ISU-MAVRIC/MAVRIC_Main/README.md

MAVRIC Main Controller
===========

Hardware and firmware for MAVRIC's main control system

Hardware design files use the [Aerodyne Labs KiCad library](https://github.com/aerodynelabs/kicadlib)

Based off the [ChipKit MAX32](http://www.digilentinc.com/Products/Detail.cfm?NavPath=2,892,894&Prod=CHIPKIT-MAX32)
