ISU-MAVRIC/MAVRIC_Main/(threads)

Thread 10 (2015-02-18):

Add microcontroller power components to board inc. regulator

markrusciano, 2015-02-18:
Using the Arm Board schematic as reference, add a 3.3V regulator to the board and connect them to the microcontroller. Use the AOZ1280 regulator. The STM32F401 datasheet is in the MAVRIC_Arm repository for power reference. Page 57 has a nice overview.

djmallek, 2015-02-21:
Layed out the STM pins, created the 3.3v regulator, hooked up 3.3v to microcontroller, and hooked up an oscillator.

Closed 2015-03-07.

Thread 11 (2015-02-18):

Add RS485 transceiver to board

markrusciano, 2015-02-18:
Use the same part that the arm board uses. The datasheet is in the MAVRIC_Arm repo as _sn65176b Datasheet.pdf_. You will need to add a terminating resistance across lines _A_ and _B_. It will be 100 Ohms. See the arm board for reference, it will be nearly identical. Use the same connector as the arm board.

A 5V regulator will also be necessary for the transceiver. Use the AOZ1280. A 5V configuration is available for reference on the arm board. I'd recommend putting the two regulators (3.3 and 5V) on a hierarchical sheet. http://en.wikibooks.org/wiki/Kicad/eeschema/Hierarchical_Sheets

Closed 2015-03-07.

Thread 9 (2015-02-18):

Layout F401 on board

markrusciano, 2015-02-18:
Using the MAVRIClib in ISU_MAVRIC/MAVRIC_Hardware, place all parts of the F401 on the board. Use the Arm Board as reference

djmallek, 2015-02-21:
I layed out all the parts for the F401.

Closed 2015-02-21.

Thread 12 (2015-03-09):

Add RJ45 connectors to schematic

markrusciano, 2015-03-09:
- [x] Wheel Pods 1-6
- [x] Arm control board

markrusciano, 2015-04-07:
Updated requirements:
- [ ] One jack for wheel pods left (we are splicing the three together)
- [ ] One jack for wheel pods right (splicing the three wheel pods together)
- [ ] One jack for Arm Control Board
- [ ] One spare jack

djmallek, 2015-05-02:
Changed spare RS485 to RS232

Closed 2015-05-02.

Thread 14 (2015-04-02):

Add Vernier Sensors to Board

markrusciano, 2015-04-02:
Sparkfun Board: http://www.vernier.com/products/interfaces/bt-ard/
- [x] pH sensor
   - [x] Figure out how to scale voltage (goes through a Vernier BNC amplifier)
   - [x] Create schematic part and board footprint for the analog British telecom plug
   - [x] Add to board, assign analog port in _cube_
- [x] Soil Moisture Sensor
 - [x] Figure out how to scale voltage (goes through a Vernier BNC amplifier)
 - [x] Add to board, assign analog port in _cube_

markrusciano, 2015-04-02:
Notes on 5V to 3.3V on Page 38 here
http://www.newark.com/pdfs/techarticles/microchip/3_3vto5vAnalogTipsnTricksBrchr.pdf

markrusciano, 2015-04-02:
Ordered bta jacks for testing on breadboard
https://www.sparkfun.com/products/12753

djmallek, 2015-05-02:
Hardware is done.

Closed 2015-06-22.

Thread 15 (2015-04-02):

Add 5V and 3V3 Regulators to Main Board

markrusciano, 2015-04-02:
- [x] 5V [AOZ1280CI](http://www.digikey.com/product-detail/en/AOZ1280CI/785-1277-1-ND/2769845)
  - [x] Added to schematic (wired to ethernet jacks)

- [x] 3V3 [AOZ1280CI](http://www.digikey.com/product-detail/en/AOZ1280CI/785-1277-1-ND/2769845)
  - [x] Added to schematic (wired to ethernet jacks)

Closed 2015-04-04.

Thread 16 (2015-04-07):

Spare Connectors

markrusciano, 2015-04-07:
The main board is probably the most volatile part of the MAVRIC electronics right now. Due to that lets add
- [x] 5 Spare GPIO I/O pins on a header
- [x] 3 Spare ADC pins on a header

Closed 2015-05-02.

Thread 17 (2015-04-07):

RFD900 Power Regulator Replacement.

markrusciano, 2015-04-07:
The RFD900 radio will be interfacing directly with the main board. It draws 800mA at 5V which may overdraw our current regulator. We might as well upgrade to one of the AP***** regulators we have used on the main board.

-[ ] Replace AOZ regulator with AP regulator (5A) running at 5V
-[ ] Add header for connecting to RFD according to pinout here http://rfdesign.com.au/index.php/rfd900 (we will only need 5V, GND, RX and TX. ) Don't connect RX and TX to anything quite yet, we still need to figure out where we want those to go.
