ISU-MAVRIC/MAVRIC_Main/Hardware/Main Board.kicad_pcb

## KiCad design Hardware/Main Board.kicad_pcb (2015-05-05)

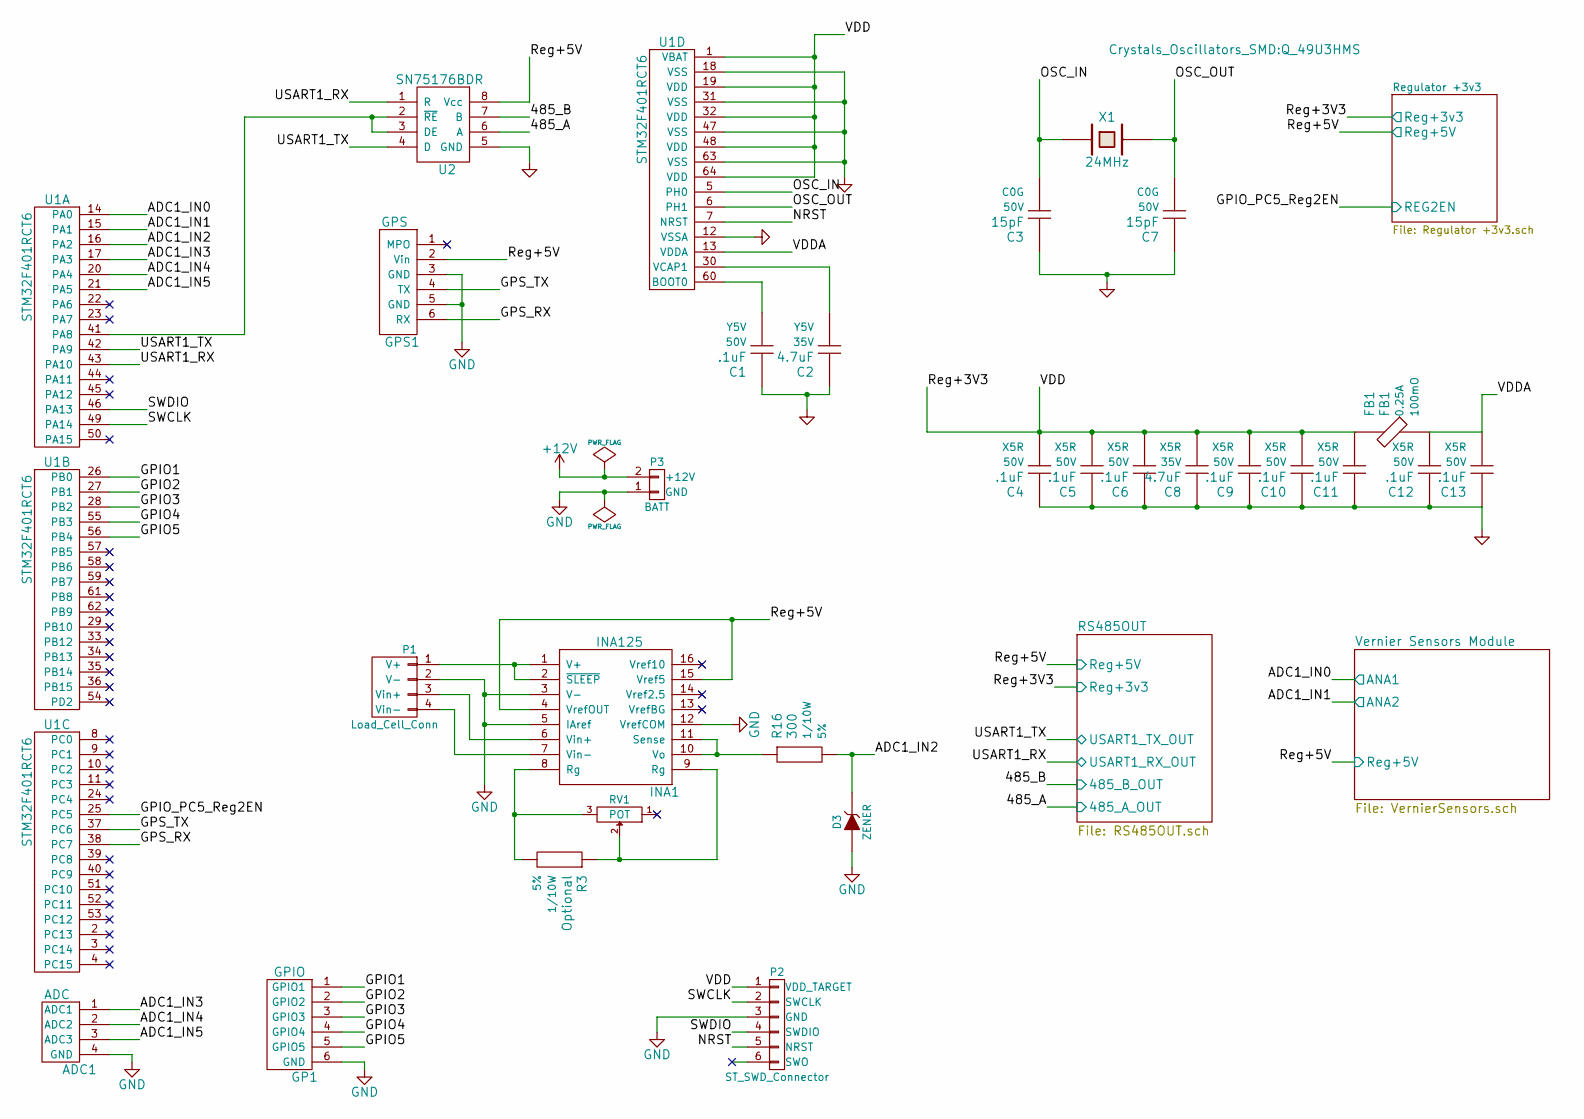
[picture p1: schematic Main Board.sch]

Parts:
ADC1: ADC; 1x4_SMD_header
C1, C4, C5, C6, C9, C10, C11, C12, C13: .1uF; C_1206_HandSoldering; Voltage 50V; Manufacturer Part # Value
C2, C8: 4.7uF; C_1206_HandSoldering; Voltage 35V; Manufacturer Part # Value
C3, C7: 15pF; C_1206_HandSoldering; Voltage 50V; Manufacturer Part # Value
D3: ZENER; Diode-SMA_Handsoldering
FB1: FB1; R_1206_HandSoldering; Manufacturer Part # Value
GP1: GPIO; 1x6_SMD_header
GPS1: GPS; GPS_Pads
INA1: INA125; SOIC-16_3.9x9.9mm_Pitch1.27mm
P1: Load_Cell_Conn; 1x4_SMD_header
P2: ST_SWD_Connector; 1x6_Breakaway_Header
P3: BATT; SolderWirePad_2x_2-5mmDrill
R3: Optional; R_1206_HandSoldering; Tolerance 5%; Manufacturer Part # Value
R16: 300; R_1206_HandSoldering; Tolerance 5%; Manufacturer Part # Value
RV1: POT; Potentiometer_Bourns_3006P_Angular_ScrewFront
U1: STM32F401RCT6; LQFP-64_10x10mm_Pitch0.5mm
U2: SN75176BDR; SOIC-8_3.9x4.9mm_Pitch1.27mm
X1: 24MHz; Q_49U3HMS

Connections:
+12V: P3.2 (+12V); also elsewhere on the board
/ADC1_IN2: D3.2 (K), R16.2, U1.16 (PA2)
/ADC1_IN3: ADC1.1 (ADC1), U1.17 (PA3)
/ADC1_IN4: ADC1.2 (ADC2), U1.20 (PA4)
/ADC1_IN5: ADC1.3 (ADC3), U1.21 (PA5)
/GPIO1: GP1.1 (GPIO1), U1.26 (PB0)
/GPIO2: GP1.2 (GPIO2), U1.27 (PB1)
/GPIO3: GP1.3 (GPIO3), U1.28 (PB2)
/GPIO4: GP1.4 (GPIO4), U1.55 (PB3)
/GPIO5: GP1.5 (GPIO5), U1.56 (PB4)
/GPS_RX: GPS1.6 (RX), U1.38 (PC7)
/GPS_TX: GPS1.4 (TX), U1.37 (PC6)
/NRST: P2.5 (NRST), U1.7 (NRST)
/OSC_IN: C3.2, U1.5 (PH0), X1.1
/OSC_OUT: C7.2, U1.6 (PH1), X1.2
/RS485OUT/485_A_OUT: U2.6 (A); also elsewhere on the board
/RS485OUT/485_B_OUT: U2.7 (B); also elsewhere on the board
/RS485OUT/Reg+3V3: C4.2, C5.2, C6.2, C8.2, C9.2, C10.2, C11.2, FB1.1, P2.1 (VDD_TARGET), U1.1 (VBAT), U1.19 (VDD), U1.32 (VDD), U1.48 (VDD), U1.64 (VDD); also elsewhere on the board
/RS485OUT/Reg+5V: GPS1.2 (Vin), INA1.4 (VrefOUT), INA1.15 (Vref5), U2.8 (Vcc); also elsewhere on the board
/RS485OUT/USART1_RX_OUT: U1.43 (PA10), U2.1 (R); also elsewhere on the board
/RS485OUT/USART1_TX_OUT: U1.42 (PA9), U2.4 (D); also elsewhere on the board
/Regulator +3v3/REG2EN: U1.25 (PC5); also elsewhere on the board
/SWCLK: P2.2 (SWCLK), U1.49 (PA14)
/SWDIO: P2.4 (SWDIO), U1.46 (PA13)
/VDDA: C12.2, C13.2, FB1.2, U1.13 (VDDA)
/Vernier Sensors Module/ANA1: U1.14 (PA0); also elsewhere on the board
/Vernier Sensors Module/ANA2: U1.15 (PA1); also elsewhere on the board
GND: ADC1.4 (GND), C1.1, C2.1, C3.1, C4.1, C5.1, C6.1, C7.1, C8.1, C9.1, C10.1, C11.1, C12.1, C13.1, D3.1 (A), GP1.6 (GND), GPS1.3 (GND), GPS1.5 (GND), INA1.3 (V-), INA1.5 (IAref), INA1.12 (VrefCOM), P1.2 (V-), P2.3 (GND), P3.1 (GND), U1.12 (VSSA), U1.18 (VSS), U1.31 (VSS), U1.47 (VSS), U1.63 (VSS), U2.5 (GND); also elsewhere on the board
unnamed: C1.2, U1.60 (BOOT0)
unnamed: C2.2, U1.30 (VCAP1)
unnamed: INA1.1 (V+), INA1.2 (~SLEEP), P1.1 (V+)
unnamed: INA1.6 (Vin+), P1.3 (Vin+)
unnamed: INA1.7 (Vin-), P1.4 (Vin-)
unnamed: INA1.8 (Rg), R3.2, RV1.3
unnamed: INA1.9 (Rg), R3.1, RV1.2
unnamed: INA1.10 (Vo), INA1.11 (Sense), R16.1
unnamed: U1.41 (PA8), U2.2 (~RE), U2.3 (DE)

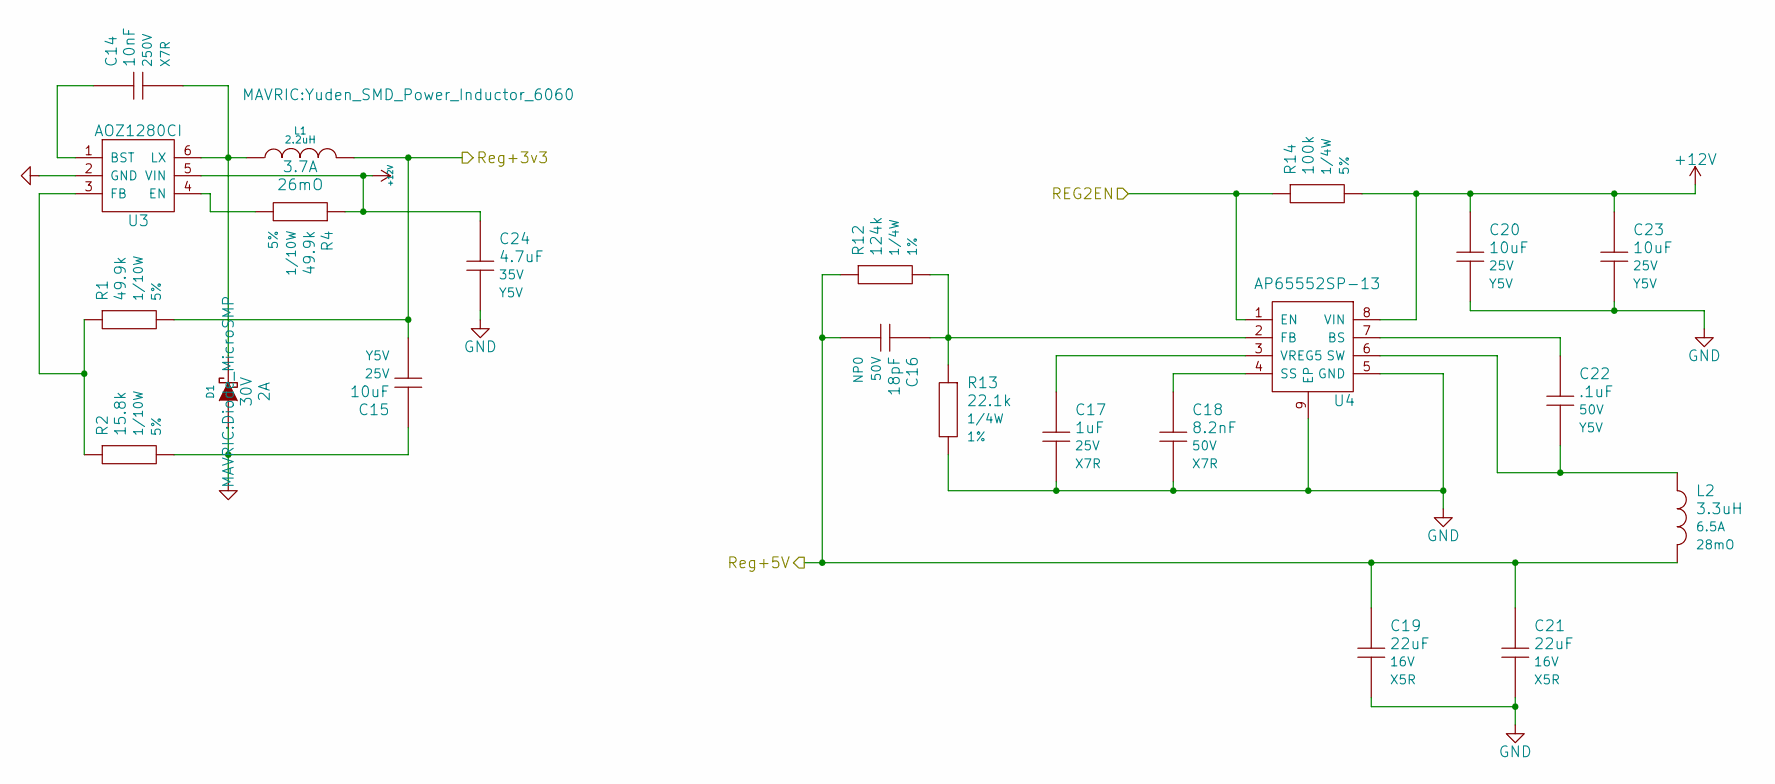
[picture p2: schematic Regulator +3v3.sch]

Parts:
C14: 10nF; C_1206_HandSoldering; Voltage 250V; Manufacturer Part # Value
C15, C20, C23: 10uF; C_1206_HandSoldering; Voltage 25V; Manufacturer Part # Value
C16: 18pF; C_1206_HandSoldering; Voltage 50V; Manufacturer Part # Value
C17: 1uF; C_1206_HandSoldering; Voltage 25V; Manufacturer Part # Value
C18: 8.2nF; C_1206_HandSoldering; Voltage 50V; Manufacturer Part # Value
C19, C21: 22uF; C_1206_HandSoldering; Voltage 16V; Manufacturer Part # Value
C22: .1uF; C_1206_HandSoldering; Voltage 50V; Manufacturer Part # Value
C24: 4.7uF; C_1206_HandSoldering; Voltage 35V; Manufacturer Part # Value
D1: DIODESCH; Diode_MicroSMP; Reverse Voltage 30V
L1: 2.2uH; Yuden_SMD_Power_Inductor_6060
L2: 3.3uH; Neosid_Inductor_SM-PIC0612H; Manufacturer Part # Value
R1, R4: 49.9k; R_1206_HandSoldering; Tolerance 5%; Manufacturer Part # Value
R2: 15.8k; R_1206_HandSoldering; Tolerance 5%; Manufacturer Part # Value
R12: 124k; R_1206_HandSoldering; Tolerance 1%; Manufacturer Part # Value
R13: 22.1k; R_1206_HandSoldering; Tolerance 1%; Manufacturer Part # Value
R14: 100k; R_1206_HandSoldering; Tolerance 5%; Manufacturer Part # Value
U3: AOZ1280CI; SOT-23-6
U4: AP65552SP-13; SOIC-8-1EP_3.9x4.9mm_Pitch1.27mm

Connections:
+12V: C20.1, C23.1, C24.1, R4.1, R14.2, U3.5 (VIN), U4.8 (VIN); also elsewhere on the board
/RS485OUT/Reg+3V3: C15.2, L1.2, R1.2; also elsewhere on the board
/RS485OUT/Reg+5V: C16.2, C19.1, C21.1, L2.2, R12.1; also elsewhere on the board
/Regulator +3v3/REG2EN: R14.1, U4.1 (EN); also elsewhere on the board
GND: C15.1, C17.2, C18.2, C19.2, C20.2, C21.2, C23.2, C24.2, D1.1 (A), R2.2, R13.2, U3.2 (GND), U4.5 (GND), U4.9 (EP); also elsewhere on the board
unnamed: C14.1, U3.1 (BST)
unnamed: C14.2, D1.2 (K), L1.1, U3.6 (LX)
unnamed: C16.1, R12.2, R13.1, U4.2 (FB)
unnamed: C17.1, U4.3 (VREG5)
unnamed: C18.1, U4.4 (SS)
unnamed: C22.1, U4.7 (BS)
unnamed: C22.2, L2.1, U4.6 (SW)
unnamed: R1.1, R2.1, U3.3 (FB)
unnamed: R4.2, U3.4 (EN)

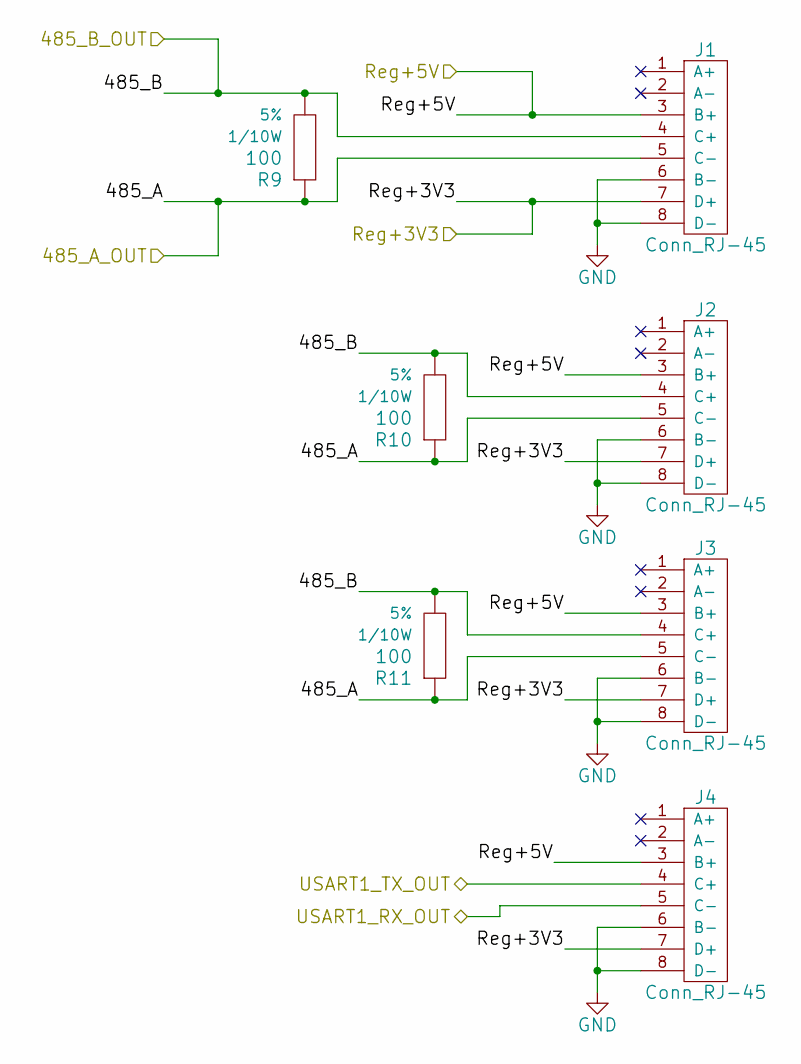
[picture p3: schematic RS485OUT.sch]

Parts:
J1, J2, J3, J4: Conn_RJ-45; Molex_RJ45_0437438101
R9, R10, R11: 100; R_1206_HandSoldering; Tolerance 5%; Manufacturer Part # Value

Connections:
/RS485OUT/485_A_OUT: J1.5 (C-), J2.5 (C-), J3.5 (C-), R9.1, R10.1, R11.1; also elsewhere on the board
/RS485OUT/485_B_OUT: J1.4 (C+), J2.4 (C+), J3.4 (C+), R9.2, R10.2, R11.2; also elsewhere on the board
/RS485OUT/Reg+3V3: J1.7 (D+), J2.7 (D+), J3.7 (D+), J4.7 (D+); also elsewhere on the board
/RS485OUT/Reg+5V: J1.3 (B+), J2.3 (B+), J3.3 (B+), J4.3 (B+); also elsewhere on the board
/RS485OUT/USART1_RX_OUT: J4.5 (C-); also elsewhere on the board
/RS485OUT/USART1_TX_OUT: J4.4 (C+); also elsewhere on the board
GND: J1.6 (B-), J1.8 (D-), J2.6 (B-), J2.8 (D-), J3.6 (B-), J3.8 (D-), J4.6 (B-), J4.8 (D-); also elsewhere on the board

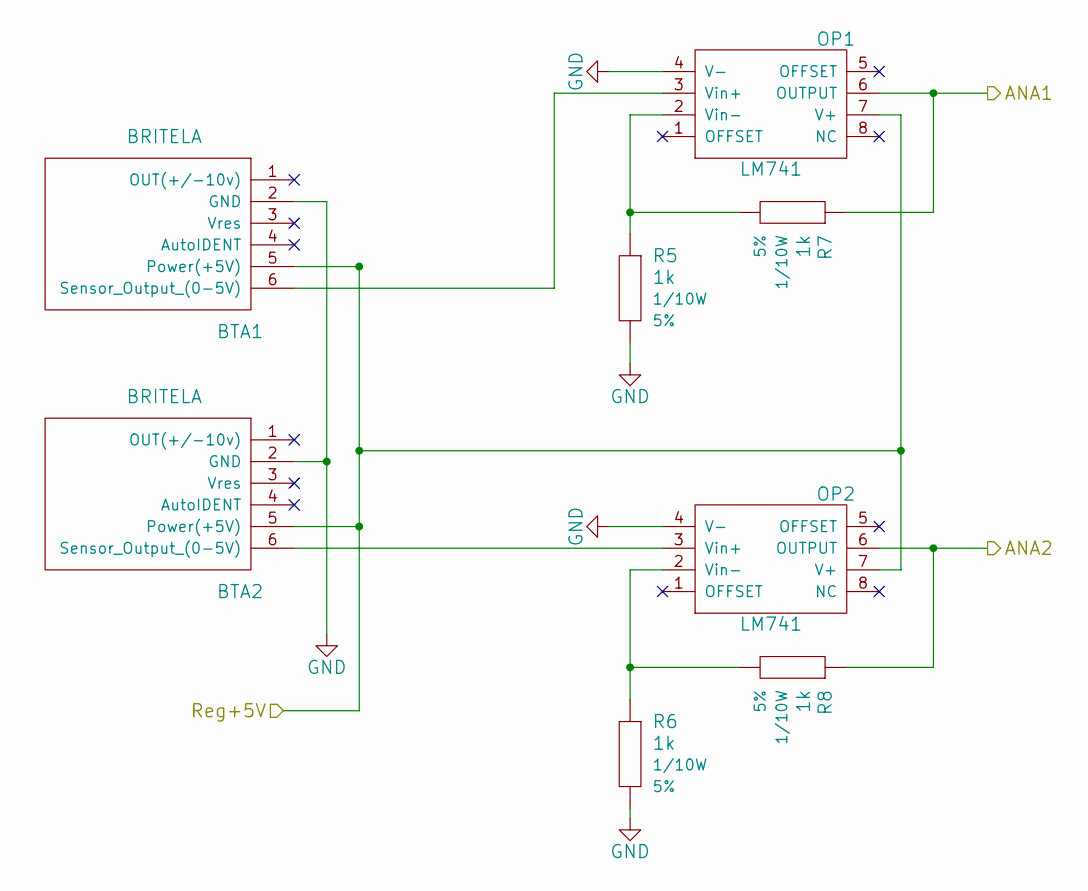
[picture p4: schematic VernierSensors.sch]

Parts:
BTA1, BTA2: BRITELA; BTA
OP1, OP2: LM741; SOIC-8_3.9x4.9mm_Pitch1.27mm
R5, R6, R7, R8: 1k; R_1206_HandSoldering; Tolerance 5%; Manufacturer Part # Value

Connections:
/RS485OUT/Reg+5V: BTA1.5 (Power(+5V)), BTA2.5 (Power(+5V)), OP1.7 (V+), OP2.7 (V+); also elsewhere on the board
/Vernier Sensors Module/ANA1: OP1.6 (OUTPUT), R7.1; also elsewhere on the board
/Vernier Sensors Module/ANA2: OP2.6 (OUTPUT), R8.1; also elsewhere on the board
GND: BTA1.2 (GND), BTA2.2 (GND), OP1.4 (V-), OP2.4 (V-), R5.2, R6.2; also elsewhere on the board
unnamed: BTA1.6 (Sensor_Output_(0-5V)), OP1.3 (Vin+)
unnamed: BTA2.6 (Sensor_Output_(0-5V)), OP2.3 (Vin+)
unnamed: OP1.2 (Vin-), R5.1, R7.2
unnamed: OP2.2 (Vin-), R6.1, R8.2

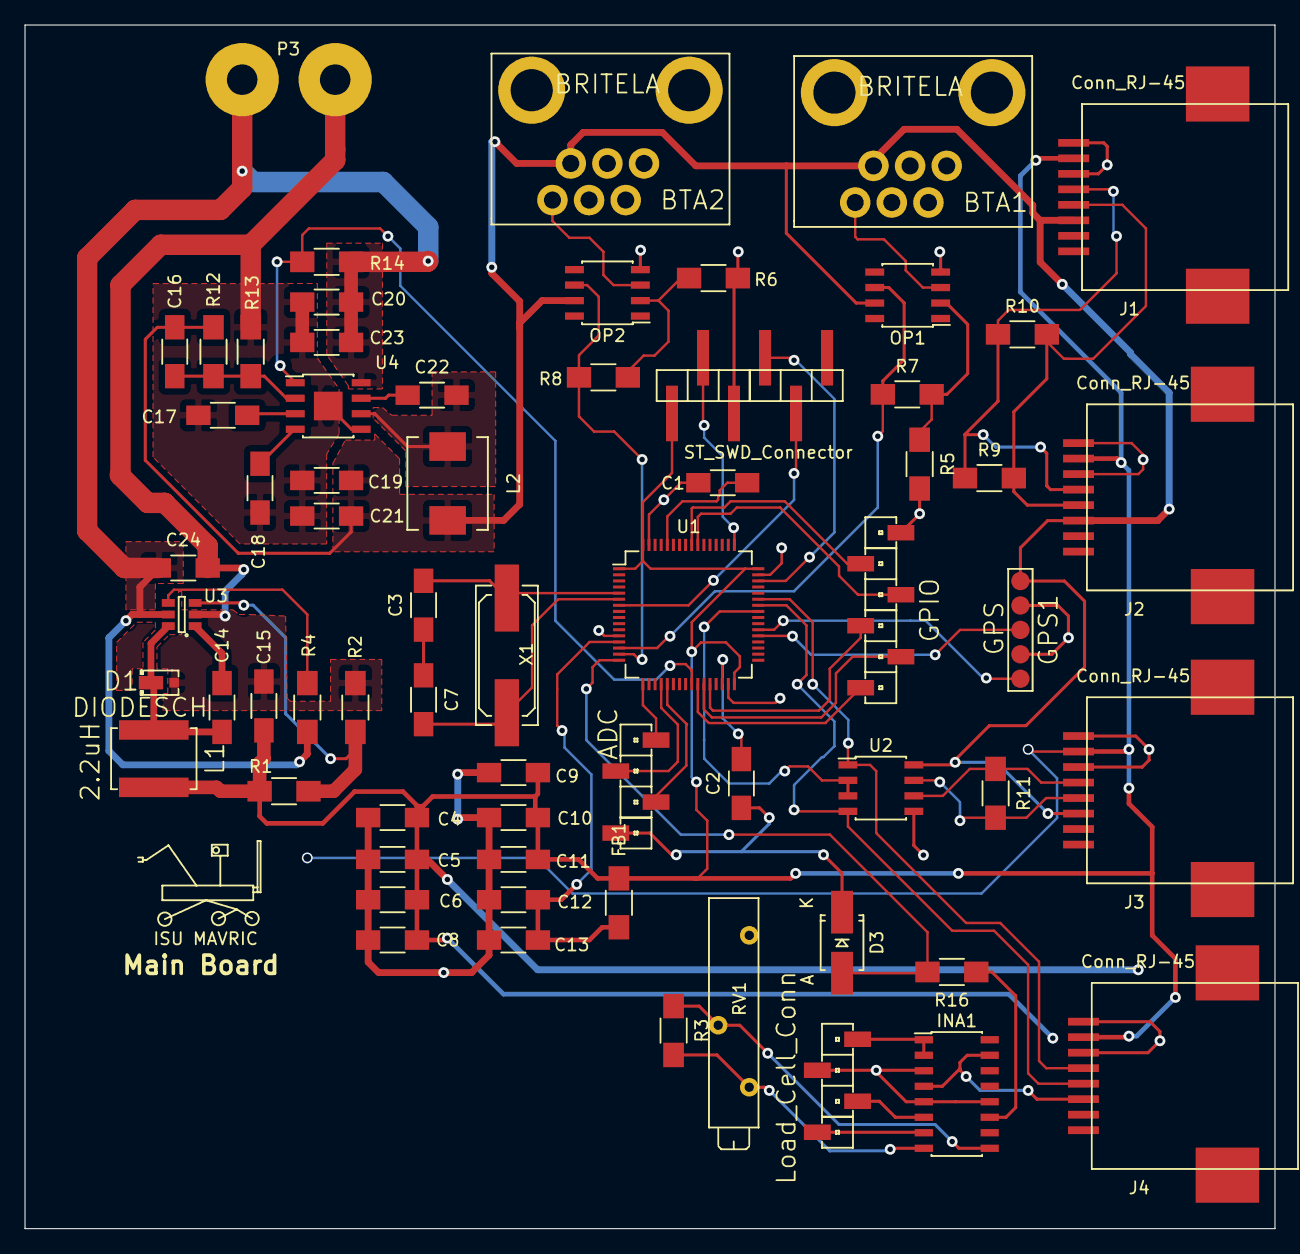
[picture p5: board Main Board.kicad_pcb from above]

Board: 2 copper layers, 102.4 x 98.6 mm, 66 parts (0 on the bottom side), 50 nets.

Other parts of the board:
ISU MAVRIC: VAL**; MAVRIC_LOGO
