ISU-MAVRIC/MAVRIC_Main/Hardware/MAVRIC-Main.kicad_pcb

## KiCad design Hardware/MAVRIC-Main.kicad_pcb (2013-09-12)

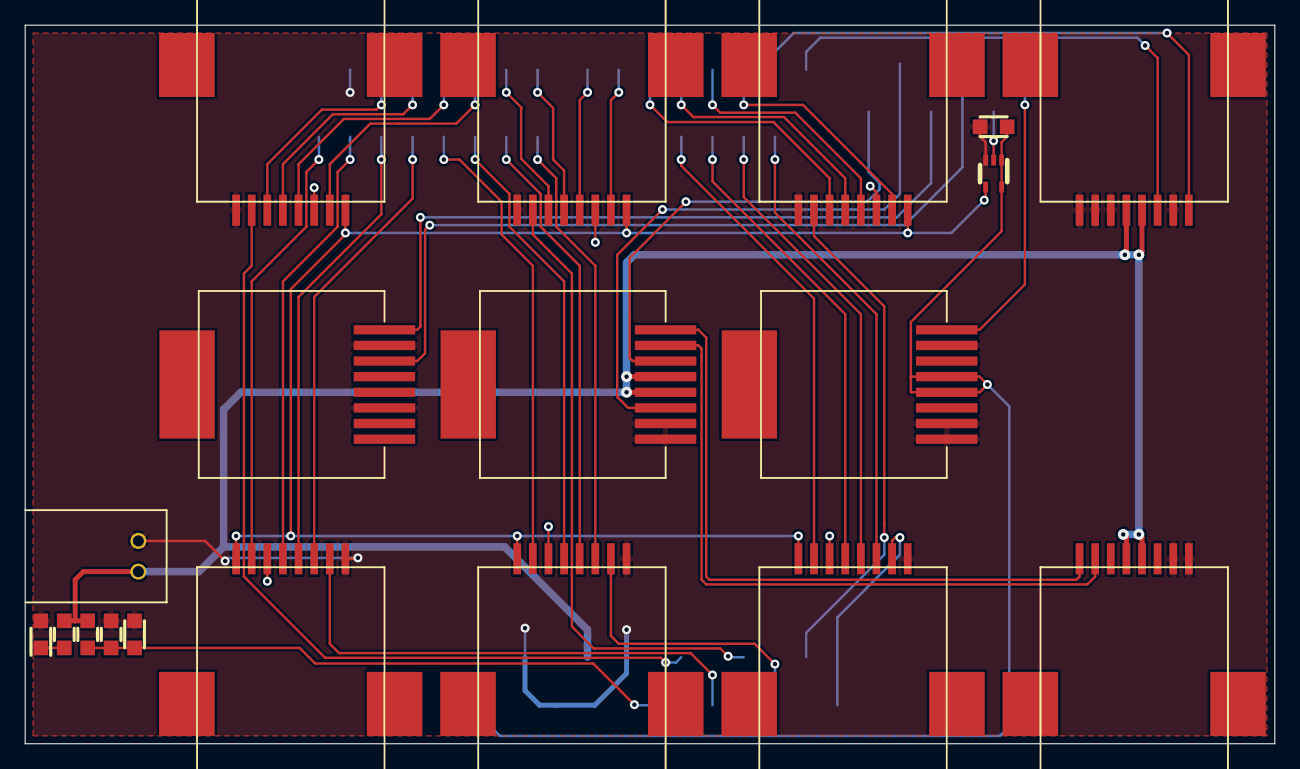
[picture p6: board MAVRIC-Main.kicad_pcb from above]

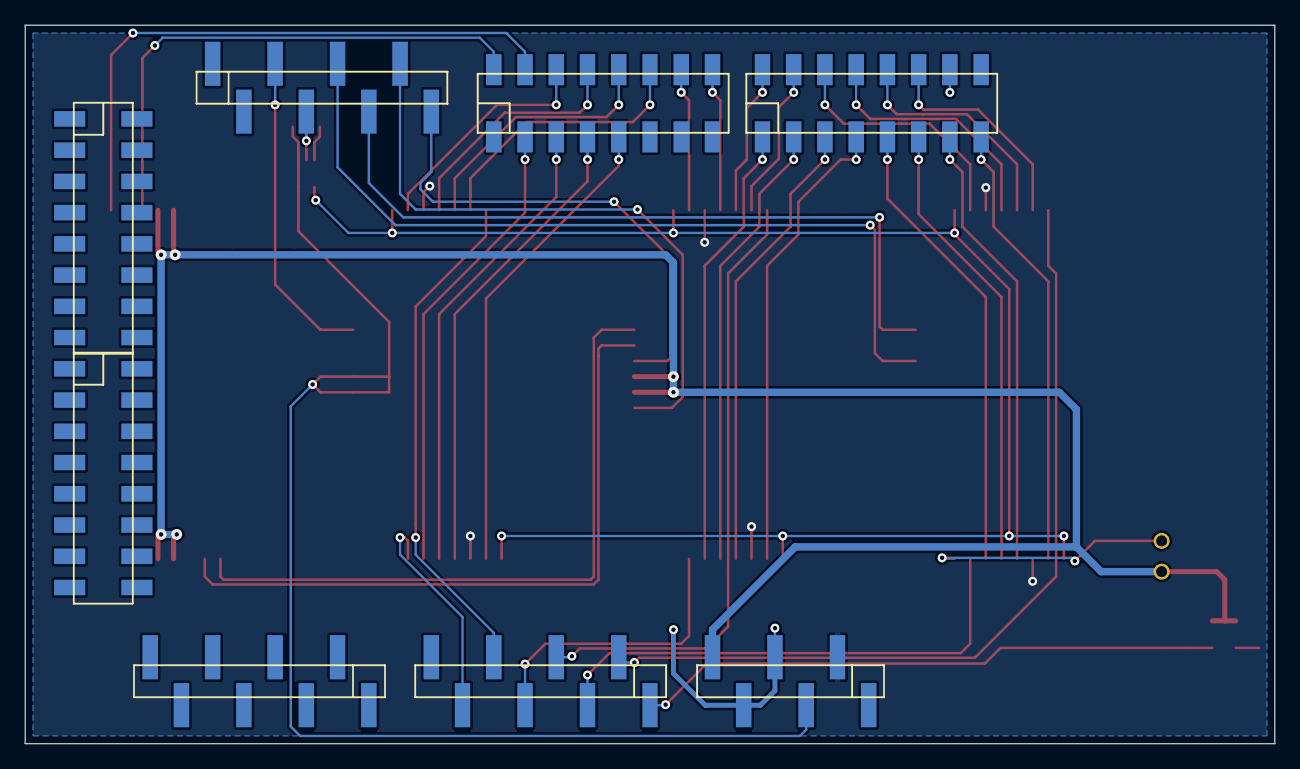
[picture p7: board MAVRIC-Main.kicad_pcb from below]

Board: 2 copper layers, 101.6 x 58.4 mm, 27 parts (8 on the bottom side), 47 nets.

Parts:
C1, C2: 0.1uF; CAPC2012
D1: LED; LEDC2012
J1: MTR1; CONN-WM6469CT
J2: MTR4; CONN-WM6469CT
J3: MTR2; CONN-WM6469CT
J4: MTR5; CONN-WM6469CT
J5: MTR3; CONN-WM6469CT
J6: MTR6; CONN-WM6469CT
J7: VID; CONN-WM6469CT
J8: DAT; CONN-WM6469CT
J9: ARM; CONN-WM3553CT
J10: CAM; CONN-WM3553CT
J11: CK-PWR; HDRV6W38P254_6X1-SMT
J12: CK-A0; HDRV8W38P254_8X1-SMT
J13: CK-A1; HDRV8W38P254_8X1-SMT
J14: CK-COM; HDRV8W38P254_8X1-SMT
J15: CK-D0; HDRV16W64P254_8X2-SMT
J16: CK-X0; HDRV16W64P254_8X2-SMT
J17: CK-D1; HDRV16W64P254_8X2-SMT
J18: CK-X1; HDRV16W64P254_8X2-SMT
J19: GPS; CONN-WM3553CT
J20: CONN-DC; CONN-JST-XH-2
R1: 36k; RESC2012
R2: 10k; RESC2012
R3: R; RESC2012
U1: SN74LVC1G125; SOT65P210X110-5N

Connections:
+3.3V: J1.3, J2.3, J3.3, J4.3, J5.3, J6.3, J11.2
+5V: C1.1, J11.3, J19.4, J19.5, U1.1, U1.5
+BATT: J7.4, J7.5, J8.4, J8.5, J10.4, J10.5, J11.6, J20.1, R1.2, R3.2
/A0: C2.1, J12.1, R1.1, R2.2
/A1: J2.7, J12.2
/A2: J1.7, J12.3
/A3: J4.7, J12.4
/A4: J3.7, J12.5
/A5: J6.7, J12.6
/A6: J5.7, J12.7
/CK2: J6.2, J15.6
/CK3: J6.4, J15.8
/CK4: J6.5, J15.10
/CK5: J6.6, J15.12
/CK6: J4.2, J15.14
/CK7: J4.4, J15.16
/CK8: J4.5, J17.2
/CK9: J4.6, J17.4
/CK10: J2.2, J17.6
/CK11: J2.4, J17.8
/CK12: J2.5, J17.10
/CK13: J2.6, J17.12
/CK71: J5.6, J15.3
/CK72: J5.5, J15.5
/CK73: J5.4, J15.7
/CK74: J5.2, J15.9
/CK78: J3.6, J17.1
/CK79: J3.5, J17.3
/CK80: J3.4, J17.5
/CK81: J3.2, J17.7
/CK82: J1.6, J17.9
/CK83: J1.5, J17.11
/CK84: J1.4, J17.13
/CK85: J1.2, J17.15
/MotorTx: J1.1, J2.1, J3.1, J4.1, J5.1, J6.1, U1.4
/RX0: J8.3, J15.2
/RX1: J14.3, J19.1
/RX2: J9.3, J14.5
/RX3: J10.6, J14.7
/TX0: J8.1, J15.4
/TX1: J14.4, U1.2
/TX2: J9.1, J14.6
/TX3: J10.3, J14.8
/VidGnd: J7.1, J10.1
/Video: J7.2, J10.2
GND: C1.2, C2.2, D1.1, J1.8, J2.8, J3.8, J4.8, J5.8, J6.8, J7.7, J7.8, J8.2, J8.6, J8.7, J8.8, J9.2, J9.6, J10.7, J10.8, J11.4, J11.5, J17.14, J19.2, J19.7, J19.8, J20.2, R2.1, U1.3
unnamed: D1.2, R3.1
