ISU-MAVRIC/MAVRIC_Main/Firmware/main_board/main_board.h

#ifndef MAVRIC_main_board_h
#define MAVRIC_main_board_h

#include <stdint.h>

#define BUFFER_LENGTH 16

const int motorEnum[] = {85, 81, 74, 10, 6, 2};
const int motorCount = sizeof(motorEnum) / sizeof(motorEnum[0]);

/* Type that is used for motor controls */
struct motorByte {
  uint8_t motor_1;
  uint8_t motor_2;
  uint8_t motor_3;
  uint8_t motor_4;
  uint8_t motor_5;
  uint8_t motor_6;
};

#endif
