ISU-MAVRIC/MAVRIC_Main/(commit log)

2013-09-07 Create KiCad project
    [MAVRIC-Main.kicad_pcb, MAVRIC-Main.sch]
2013-09-07 Add basic connector and ChipKit headers
    [MAVRIC-Main.kicad_pcb, MAVRIC-Main.sch]
2013-09-07 Replace arm and camera connectors with vertical style
    [MAVRIC-Main.kicad_pcb, MAVRIC-Main.sch]
2013-09-08 Reload packages for 3D models and fix typo
    See AerodyneLabs/KiCadLib@c14934719a961a2749f372fa06ca804ae15d519b for
    typo
    [MAVRIC-Main.kicad_pcb]
2013-09-09 Swap vid/agnd to comply with camera change
    [MAVRIC-Main.kicad_pcb, MAVRIC-Main.sch]
2013-09-10 Rough pin out of most systems
    [MAVRIC-Main.kicad_pcb, MAVRIC-Main.sch]
2013-09-12 Finish 1v0 circuit board!
    [MAVRIC-Main.kicad_pcb, MAVRIC-Main.sch]
2013-09-28 Add some bom values
    [MAVRIC-Main.sch]
2013-10-01 Control motors using packetized serial mode
2013-11-12 Beginning of inter-board communication
    Changed serial buffer to pass entire commands
2014-09-16 Added Feature: Wheels Turn Now
2014-09-16 Serial Control: Forward and Reverse
    [WheelControl.pde]
2014-09-16 Fixed the serial to match wireless speed
    [WheelControl.pde]
2014-10-25 Board now accepts primative motor speed packets
    Board accepts packets in format <+000 -000> form where the first value
    is the left motor speeds and the second value is the right motor speeds.
    The packet is parsed to integers and returned over serial. Value is NOT
    sent to motors yet
2014-10-25 Primitive serial control: Motors now work
2014-11-01 Created separate program for arm control
    Duplicated wheel control, made a couple of changes for two motors versus
    six
2014-11-19 Adds Pan and Tilt control to the camera controller
2014-11-27 Adjusted for non-continuous servos
    Angle addition to allow for angle holding and pan/tilt in the negative
    direction.
2014-12-04 Fixed random motion
    Adjusted the values because servo does not tolerate values less than
    three or more than 180
    [PanTiltControl.pde]
2014-12-06 Now controls both servos and centers forward
2014-12-13 Nucleo Test Code in CoIDE
    User button toggles LED State, has debouncing issues.
2015-01-11 Basic PWM control and conversion to C++
    She's beautiful ... she's rich ... she's got huge ... tracts of
    commented out code
2015-01-11 Now two PWM pins work
    what a major world accomplishment someone call al jazeera
2015-01-11 Two PWM with more cleanup
    committing for reference when changing to timer 1 due to ST-Link
    conflict on the serial port
2015-01-11 Changed over to TIM1, added debug support
    TIM1 doesn't work currently but debugging does. It sometimes crashes
    CoIDE but I'm not sure if that's something I can fix
    [main.cpp]
2015-01-31 Filled out MAVRIC_Main, fixed minor issues
    [main.cpp]
2015-02-02 Created KiCad project and STMCube project
    [MAVRIC-Main.kicad_pcb, MAVRIC-Main.sch, Main Board.sch]
2015-03-07 Add 5v regulator and RS485 transceiver to Main board
    Added RS485 and a 5v regulator to power it
    [Main Board.sch, Regulator +3v3.sch]
2015-04-03 Add BTA breakout for Vernier sensors and convert 5v analog to 3v3
    [Main Board.sch, Regulator +3v3.sch, VernierSensors.sch]
2015-04-04 Add 485 network out, POE for Wheel Pod boards
    [Main Board.sch, RS485OUT.sch, Regulator +3v3.sch, VernierSensors.sch]
2015-04-18 Add instrumentation amplifier for load cell, added amplifiers for ph and moisture sensors
    [Main Board.sch, VernierSensors.sch]
2015-04-18 Fix capacitor annotation problem
    The capacitors from the same library were assigned the same numbers for
    an unknown reason.
    [Main Board.sch, RS485OUT.sch, Regulator +3v3.sch, VernierSensors.sch]
2015-04-24 Fix annotation problem, Add IC datasheets
    [Main Board.sch, RS485OUT.sch, Regulator +3v3.sch, VernierSensors.sch]
2015-05-02 Add GPS Pads, potentiometer to INA125, 3v3 regulator always enabled, footprints created for GPS Pads and BTA, parts assigned
    [Main Board.sch, RS485OUT.sch, Regulator +3v3.sch, VernierSensors.sch]
2015-05-02 Merge remote-tracking branch 'origin/master'
    Conflicts:
    Hardware/Main Board-cache.lib
    Hardware/Main Board.cmp
    Hardware/Main Board.net
    Hardware/Main Board.pro
    Hardware/Main Board.sch
    Hardware/RS485OUT.sch
    Hardware/Regulator +3v3.sch
    Hardware/VernierSensors.sch
    Finish schematic of Main Board
2015-05-02 Finish Main Board schematic
    [Main Board.kicad_pcb, Main Board.sch, RS485OUT.sch, Regulator +3v3.sch, VernierSensors.sch]
2015-05-05 PCB Main Board for Mark
2015-05-05 Layout of PCB
    [$Main Board.sch, Main Board.kicad_pcb]
2015-05-05 PCB Almost Complete
    [$Main Board.sch, $Regulator +3v3.sch, Main Board.kicad_pcb, Main Board.sch, VernierSensors.sch]
2015-05-05 Add ground Plane
    [$Regulator +3v3.sch, Main Board.kicad_pcb, Main Board.sch, RS485OUT.sch, Regulator +3v3.sch, VernierSensors.sch]
2015-05-05 Main Board Finished
    [Main Board.kicad_pcb, Main Board.sch, RS485OUT.sch, Regulator +3v3.sch, VernierSensors.sch]
